mmaakkyyii/Micromouse/Board/micromouse/micromouse.kicad_pcb

## KiCad design Board/micromouse/micromouse.kicad_pcb (2023-10-12)

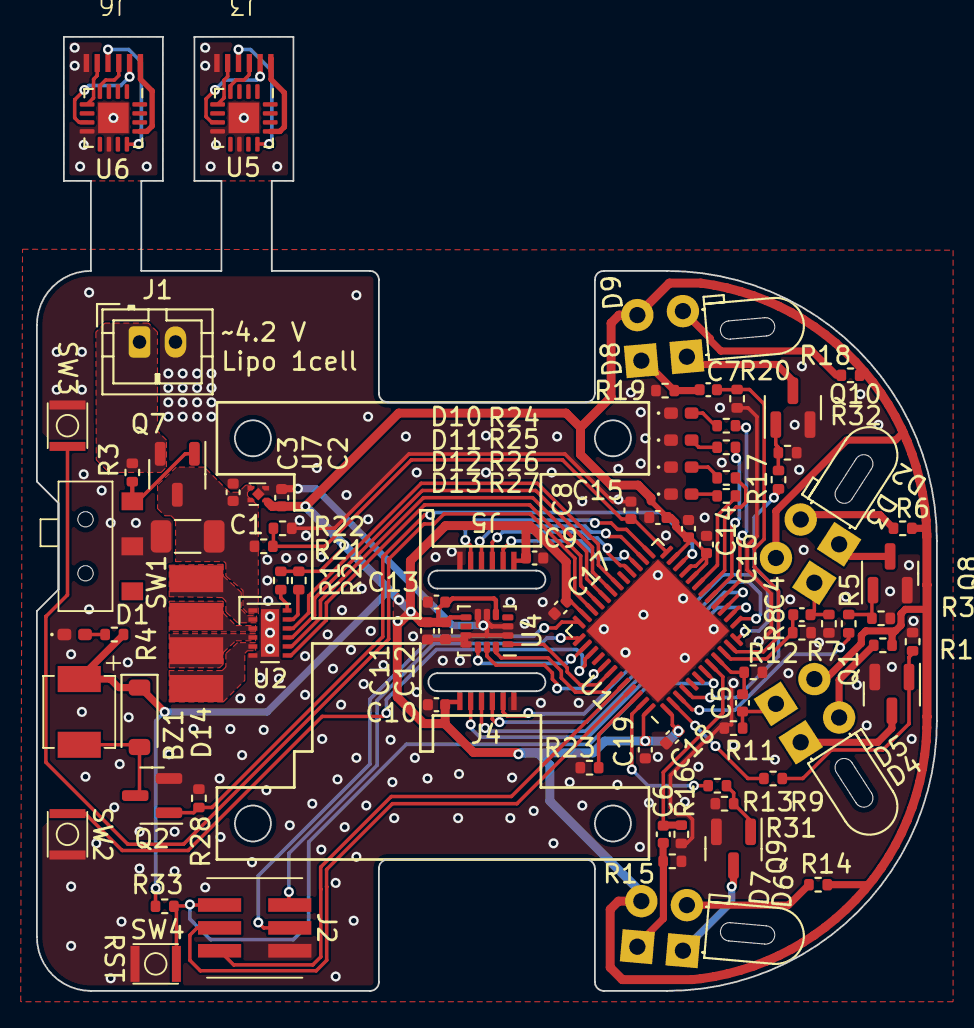
[picture p1: board micromouse.kicad_pcb from above]

Board: 2 copper layers, 50.0 x 53.0 mm, 91 parts (0 on the bottom side), 83 nets.

Parts:
BZ1: SMT-0440-T-HT-R
C1: 10u; C_1206_3216Metric
C2, C3: 1u; C_0402_1005Metric
C4, C5, C6, C7: 0.01u; C_0402_1005Metric
C8, C9, C10, C12, C14, C15, C16, C17, C18, C19: 0.1u; C_0402_1005Metric
C11: 2.2u; C_0402_1005Metric
C13: 10n; C_0402_1005Metric
D1, D10, D11, D12, D13: LED; LED_0402_1005Metric_Pad0.77x0.64mm_HandSolder
D2, D4, D6, D8: OSI5FU3A11C; LED
D3, D5, D7, D9: LTR-4206E; PhotoDiode
D14: 1N4448W-TP; D_SOD-123
J1: Conn_01x02_Pin; JST_PH_B2B-PH-K_1x02_P2.00mm_Vertical
J2: Conn_02x03_Odd_Even; 20021221-00006C4LF
J3, J4, J5, J6: Conn_01x06_Pin; ENC_CONN
M1, M2: Motor_DC; Motor_PAD
Q1, Q2, Q8, Q9, Q10: DMN63D8L-7; SOT-23
Q7: GSFC02A05; SOT-23-3
R1, R2, R23: 0; R_0402_1005Metric
R3: 100k; R_0402_1005Metric
R4, R24, R25, R26, R27: 3.3k; R_0402_1005Metric
R5, R9, R13, R17: 10; R_0402_1005Metric
R6, R10, R14, R18: 15; R_0402_1005Metric
R7, R11, R15, R19: 300; R_0402_1005Metric
R8, R12, R16, R20, R28, R29, R30, R31, R32, R33: 10k; R_0402_1005Metric
R21: 6.8k; R_0402_1005Metric
R22: 15k; R_0402_1005Metric
SW1: AYZ0102AGRLC
SW2, SW3, SW4: NANOT 100 AS
U1: STM32G474CEUx; QFN-48-1EP_7x7mm_P0.5mm_EP5.6x5.6mm
U2: DRV8836DSSR; WSON-12-1EP_3x2mm_P0.5mm_EP1x2.65
U4: ICM-42688-P; LGA-14_3x2.5mm_P0.5mm_LayoutBorder3x4y
U5, U6: MAQ473GQE-AEC1-Z; QFN-16-1EP_3x3mm_P0.5mm_EP1.7x1.7mm
U7: NCP177AMX330TCG; XDFN4 1.0x1.0, 0.65P

Connections:
+3.3V: BZ1.1 (-), C2.1, C9.1, C10.1, C11.1, C12.1, C13.1, C14.1, C15.1, C16.1, C17.1, C18.1, C19.1, D3.2 (A), D5.2 (A), D7.2 (A), D9.2 (A), D14.1 (K), J4.1, J5.1, R1.2, R2.2, R4.1, R6.1, R10.1, R14.1, R18.1, R33.1, U1.1 (VBAT), U1.20 (VREF+), U1.21 (VDDA), U1.23 (VDD), U1.35 (VDD), U1.48 (VDD), U4.5 (VDDIO), U4.8 (VDD), U7.1 (OUT)
/AIN1: U1.30 (PA8), U2.10 (AIN1/APHASE)
/AIN2: U1.31 (PA9), U2.9 (AIN2/AENBL)
/BATT_ADC: C8.1, R21.2, R22.1, U1.24 (PB11)
/BIN1: U1.32 (PA10), U2.8 (BIN1/BPHASE)
/BIN2: U1.33 (PA11), U2.7 (BIN2/BENBL)
/BUZZER: Q2.1 (G), R28.2, U1.22 (PB10)
/ENC1/ENC_CS: J6.5, U6.5 (CS)
/ENC1/ENC_GND: J6.6, U6.8 (GND), U6.10 (TEST), U6.17 (EX_PAD)
/ENC1/ENC_MISO: J6.2, U6.7 (MISO)
/ENC1/ENC_MOSI: J6.3, U6.4 (MOSI)
/ENC1/ENC_SCLK: J6.4, U6.12 (SCLK)
/ENC1/ENC_VDD: J6.1, U6.13 (VDD)
/ENC/ENC_CS: J3.5, U5.5 (CS)
/ENC/ENC_GND: J3.6, U5.8 (GND), U5.10 (TEST), U5.17 (EX_PAD)
/ENC/ENC_MISO: J3.2, U5.7 (MISO)
/ENC/ENC_MOSI: J3.3, U5.4 (MOSI)
/ENC/ENC_SCLK: J3.4, U5.12 (SCLK)
/ENC/ENC_VDD: J3.1, U5.13 (VDD)
/LED1: R24.2, U1.16 (PC4)
/LED2: R25.2, U1.17 (PB0)
/LED3: R26.2, U1.18 (PB1)
/LED4: R27.2, U1.19 (PB2)
/LED_FL: R17.1, U1.4 (PC15)
/LED_FR: R13.1, U1.47 (PB9)
/LED_L: R5.1, U1.3 (PC14)
/LED_R: R9.1, U1.2 (PC13)
/NRST: J2.1, R33.2, SW4.2, U1.7 (PG10)
/SENSOR_FL: C7.2, R20.1, U1.11 (PA3)
/SENSOR_FR: C6.2, R16.1, U1.8 (PA0)
/SENSOR_L: C4.2, R8.1, U1.10 (PA2)
/SENSOR_R: C5.2, R12.1, U1.9 (PA1)
/SPI1_CLK: J4.4, U1.13 (PA5)
/SPI1_MISO: J4.2, U1.14 (PA6)
/SPI1_MOSI: J4.3, U1.15 (PA7)
/SPI1_NSS: J4.5, U1.12 (PA4)
/SPI2_CLK: J5.4, U1.26 (PB13)
/SPI2_MISO: J5.2, U1.27 (PB14)
/SPI2_MOSI: J5.3, U1.28 (PB15)
/SPI2_NSS: J5.5, U1.25 (PB12)
/SPI3_CLK: U1.41 (PB3), U4.13 (AP_SCLK/AP_SCLK)
/SPI3_MISO: U1.42 (PB4), U4.1 (AP_SDO/AP_AD0)
/SPI3_MOSI: U1.43 (PB5), U4.14 (AP_SDA/AP_SDIO/AP_SDI)
/SPI3_NSS: U1.38 (PA15), U4.12 (AP_CS)
/SW1: SW2.2, U1.39 (PC10)
/SW2: SW3.2, U1.34 (PA12)
/SYS_JTMS-SWCLK: J2.2, U1.37 (PA14)
/SYS_JTMS-SWDIO: J2.4, U1.36 (PA13)
/UART1_RX: J2.3, U1.45 (PB7)
/UART1_TX: J2.5, U1.44 (PB6)
GND: C1.2, C2.2, C3.2, C8.2, C9.2, C10.2, C11.2, C12.2, C13.2, C14.2, C15.2, C16.2, C17.2, C18.2, C19.2, D1.1 (K), D10.1 (K), D11.1 (K), D12.1 (K), D13.1 (K), J1.2, J2.6, J4.6, J5.6, Q1.2 (S), Q2.2 (S), Q8.2 (S), Q9.2 (S), Q10.2 (S), R7.2, R8.2, R11.2, R12.2, R15.2, R16.2, R19.2, R20.2, R22.2, R23.1, R28.1, R29.2, R30.2, R31.2, R32.2, SW1.2 (B), SW2.1, SW3.1, SW4.1, U1.49 (VSS), U2.6 (GND), U2.13 (EPAD), U4.2 (RESV), U4.3 (RESV), U4.6 (GND), U4.7 (RESV), U4.10 (RESV), U4.11 (RESV), U7.2 (GND)
unnamed: BZ1.2 (+), D14.2 (A), Q2.3 (D)
unnamed: D1.2 (A), R4.2
unnamed: D2.2 (A), R6.2
unnamed: D2.1 (K), Q8.3 (D)
unnamed: C4.1, D3.1 (K), R7.1
unnamed: D4.2 (A), R10.2
unnamed: D4.1 (K), Q1.3 (D)
unnamed: C5.1, D5.1 (K), R11.1
unnamed: D6.2 (A), R14.2
unnamed: D6.1 (K), Q9.3 (D)
unnamed: C6.1, D7.1 (K), R15.1
unnamed: D8.2 (A), R18.2
unnamed: D8.1 (K), Q10.3 (D)
unnamed: C7.1, D9.1 (K), R19.1
unnamed: D10.2 (A), R24.1
unnamed: D11.2 (A), R25.1
unnamed: D12.2 (A), R26.1
unnamed: D13.2 (A), R27.1
unnamed: J1.1, Q7.2 (S), R3.1
unnamed: M1.1 (+), U2.2 (AOUT1)
unnamed: M1.2 (-), U2.3 (AOUT2)
unnamed: M2.1 (+), U2.4 (BOUT1)
unnamed: M2.2 (-), U2.5 (BOUT2)
unnamed: Q1.1 (G), R9.2, R29.1
unnamed: Q7.1 (G), R3.2, SW1.1 (A)
unnamed: Q8.1 (G), R5.2, R30.1
unnamed: Q9.1 (G), R13.2, R31.1
unnamed: Q10.1 (G), R17.2, R32.1
unnamed: R23.2, U1.46 (PB8)
unnamed: R2.1, U2.11 (MODE)
unnamed: R1.1, U2.12 (nSLEEP)
VCC: C1.1, C3.1, Q7.3 (D), R21.1, U2.1 (VCC), U7.3 (EN), U7.4 (IN)
