mmaakkyyii/Micromouse/(threads)

Thread 8 (2023-06-26):

回路設計

mmaakkyyii, 2023-06-26:

mmaakkyyii, 2023-10-05:
最新のmainブランチにて基板データを追加
https://github.com/mmaakkyyii/Micromouse/tree/main/Board/micromouse

sho6715, 2023-10-05:
スケマ
- ここのFETスイッチのSW1の向き間違ってない？
これだと常時Q7の1ピンがGNDに落ちててスイッチにならない
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
参考(hankyo2)
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

- NRSTの接続逆向きな気がする。
システムリセットはNRSTのローレベルで発生だからこれだと常時リセットになる。
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

- PB8のBOOTピンはオープンでも構わないが、設定するならプルダウンになるはず
なにか0オーム接続してからオープンにしている理由があるなら問題ない
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

- モタドラのMODEとSLEEPはPHASE/ENABLEモードで使うなら共にHIGHにしないと行けないはずだが0Ωオープンになっているのはなぜ？
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

- ハイパスフィルタの係数これでよい？カットオフ159Hz程度だけど

- 表示系LEDは1k結構明るい(参考にhankyo2は2k使ってるけど結構明るい)

- 書き込み用コネクタ見た感じ対になる基板必要な気がするけど大丈夫？無理やりピンにケーブルつける？

アートワーク
- 運用レベルだけどモードスイッチとマイコンリセットスイッチが隣接してると誤動作の原因になるから話したほうが無難
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

- 3.3VラインがFRセンサが終点になっていて不足しがちだから一周するようにして上げたほうがいい
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
例
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

- これはシルクいれられる
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

- パッド重なってる
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

- Lセンサだけ3.3V配線が細いのがきになる。0.2mmあるから電流は足りるだろうけども
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

- こんなところのベタ消していいよ
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

- 一応エラー出てる。けどここは接続部だから気にしなくてもよい
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

- LED1005でよくない？
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
hankyo2使用のもの(オレンジ)https://www.digikey.jp/ja/products/detail/kingbright/APHHS1005LSECK-J4-PF/7319052

- うさぎロゴがいない(入れないって決めるならそれでもいい)

- 直感だから違うかもしれないが、マイコン斜めに置かないほうが上側配線し易いかも...

- エンコーダ基板に左右明記しておいたほうが良い

- しなくてもいいけど、電源用コネクタは後ろ出るの覚悟でスルーホールの方がいいかも、かなり力かかるので

mmaakkyyii, 2023-10-11:
対応しました(https://github.com/mmaakkyyii/Micromouse/commit/e79fd776a8066c1f427319d594239451c132264a)
間違っていた回路はそのまま修正
HPFはPi:Coに合わせて1000kHzに
LEDの抵抗を3.3kに

書き込みピン用には変換ケーブルを作ります。

sho6715, 2023-10-11:
スケマ
- 特に気になるところはない

アートワーク
- 多分このくらいリセット離さないと操作時に押す。
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
- D1が1005になってない　意図的に変えるなら1608でもいいけど
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
- ここの3.3Vまたいでるところビア追加してもいいかも
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
- エンコーダ基板にLR書かんの？

部品表のチェックはしていないので確認しておいてください。

mmaakkyyii, 2023-10-12:
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
・ボタンの位置を離しました。 タイヤ側に持ってくるとギアと干渉するのでそこまで離せなかったです。
・LEDはすべて1005にしました
・エンコーダ基板は2つとも全く同じ回路なのでLRの区別をする必要はないです

sho6715, 2023-10-12:
- エンコーダ基板勘違いしてたのでOKです。
- OKです。
