mmaakkyyii/Micromouse/(commit log)

2023-10-05 add kicad file
    [ENC.kicad_sch, micromouse.kicad_pcb, micromouse.kicad_sch, sensor.kicad_sch]
2023-10-11 レビュー対応
    [micromouse.kicad_pcb, micromouse.kicad_sch, sensor.kicad_sch]
2023-10-11 余計なべたパターン削除
    [micromouse.kicad_pcb]
2023-10-12 ボタン位置修正
    [micromouse.kicad_pcb, micromouse.kicad_sch]
2023-10-16 部品型番、URLを追加
    [ENC.kicad_sch, micromouse.kicad_sch, sensor.kicad_sch]
